Ethan-Poag/Flight-Data-Computer/README.md

# Flight-Data-Computer
An easy to build open source alternative to the ASA CX-3 aviation data computer.
