Ethan-Poag/Flight-Data-Computer/Calculator 3D Models/Calculator housing 3D model V2.step

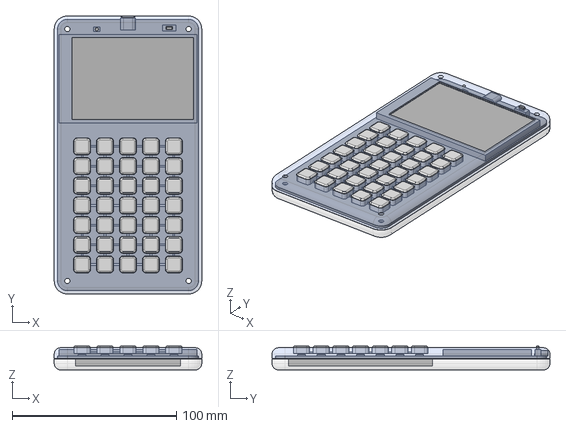
[picture p1: CAD file, 2022-11-27]
Calculator 3D Models/Calculator housing 3D model V2.step
90.0 x 169.5 x 14.6 mm
