Ethan-Poag/Flight-Data-Computer/Calculator_PCB_V3/Calculator.kicad_pcb

## KiCad design Calculator_PCB_V3/Calculator.kicad_pcb (2022-11-27)

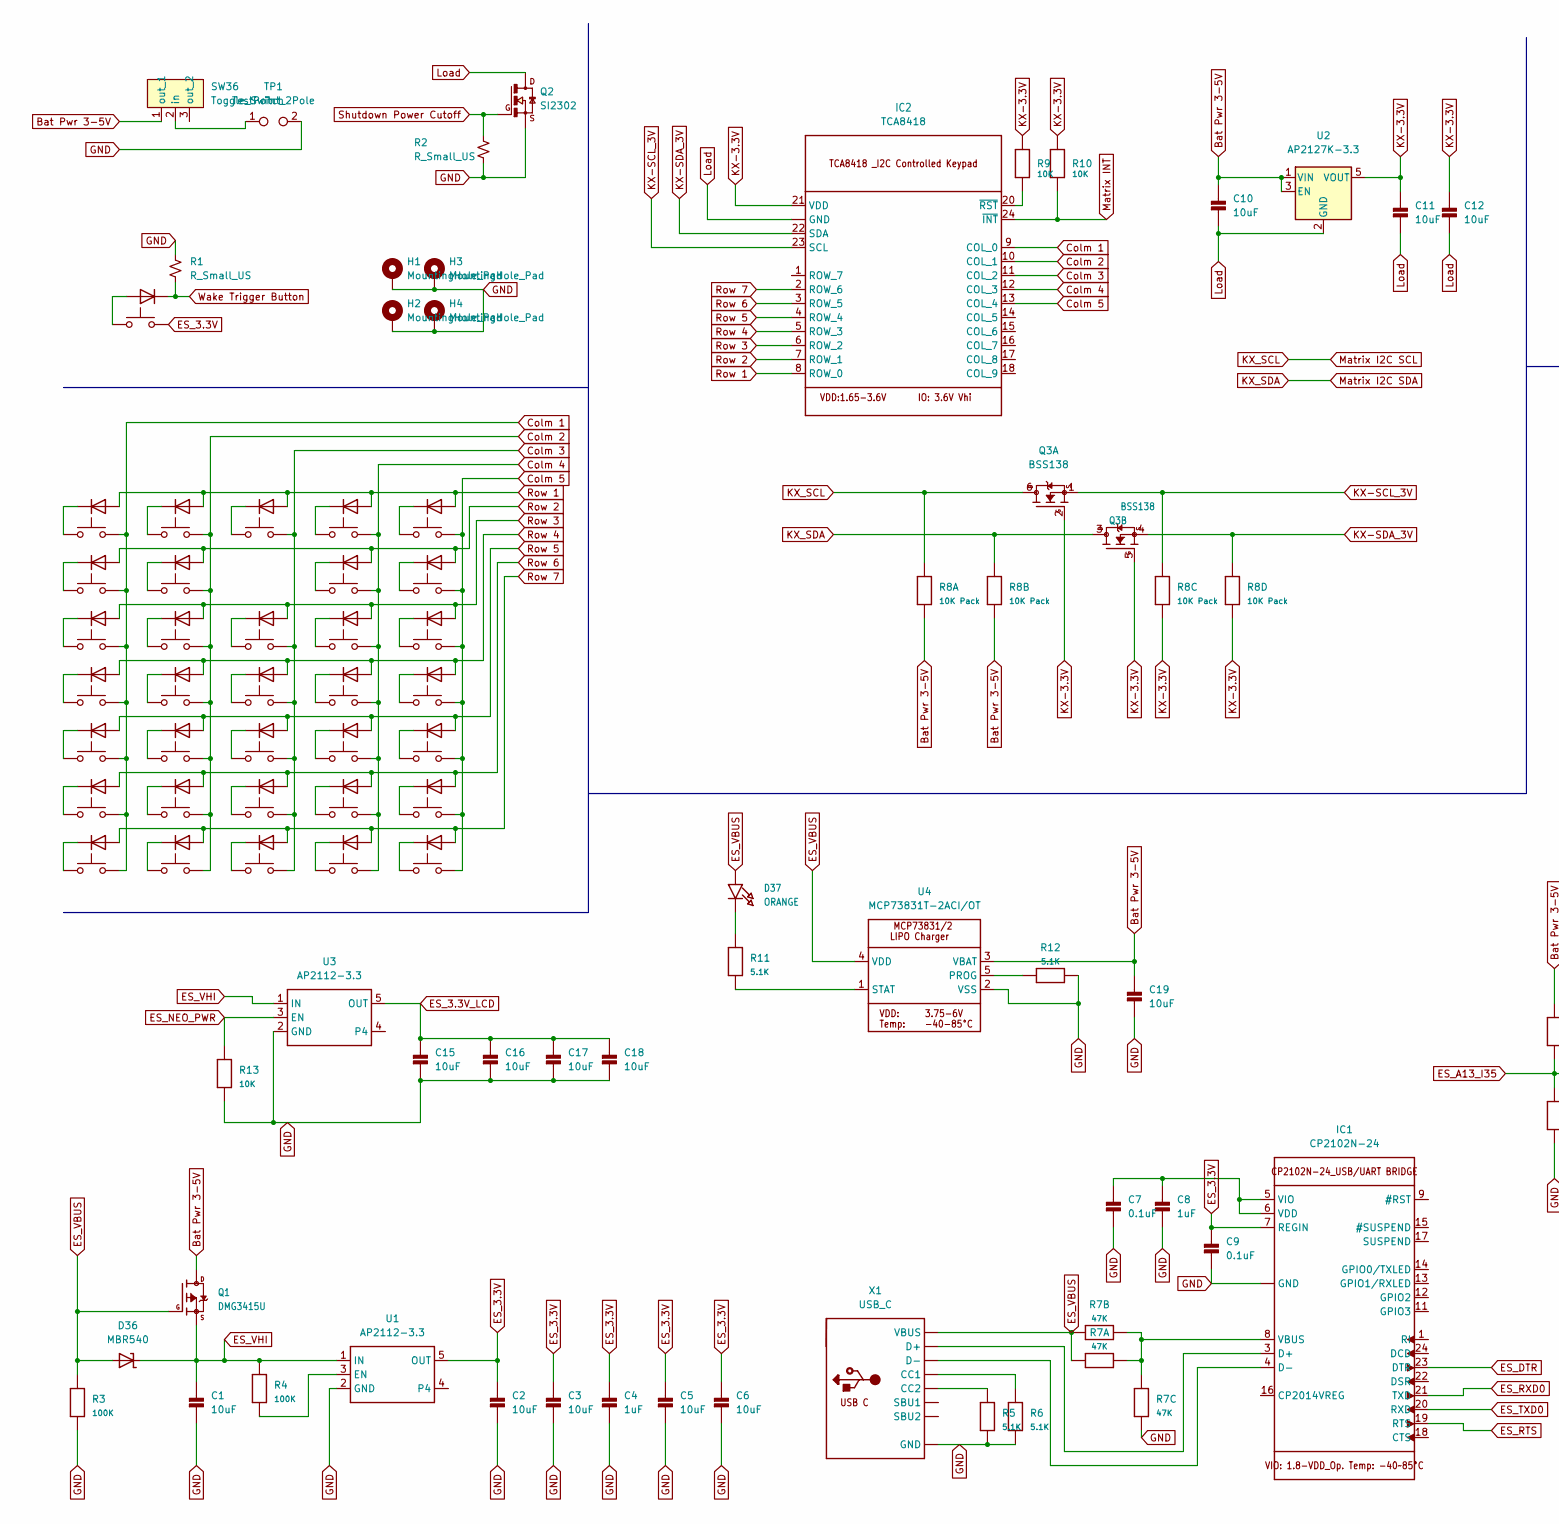
[picture p2: schematic Calculator.kicad_sch, part in row 1, column 1]

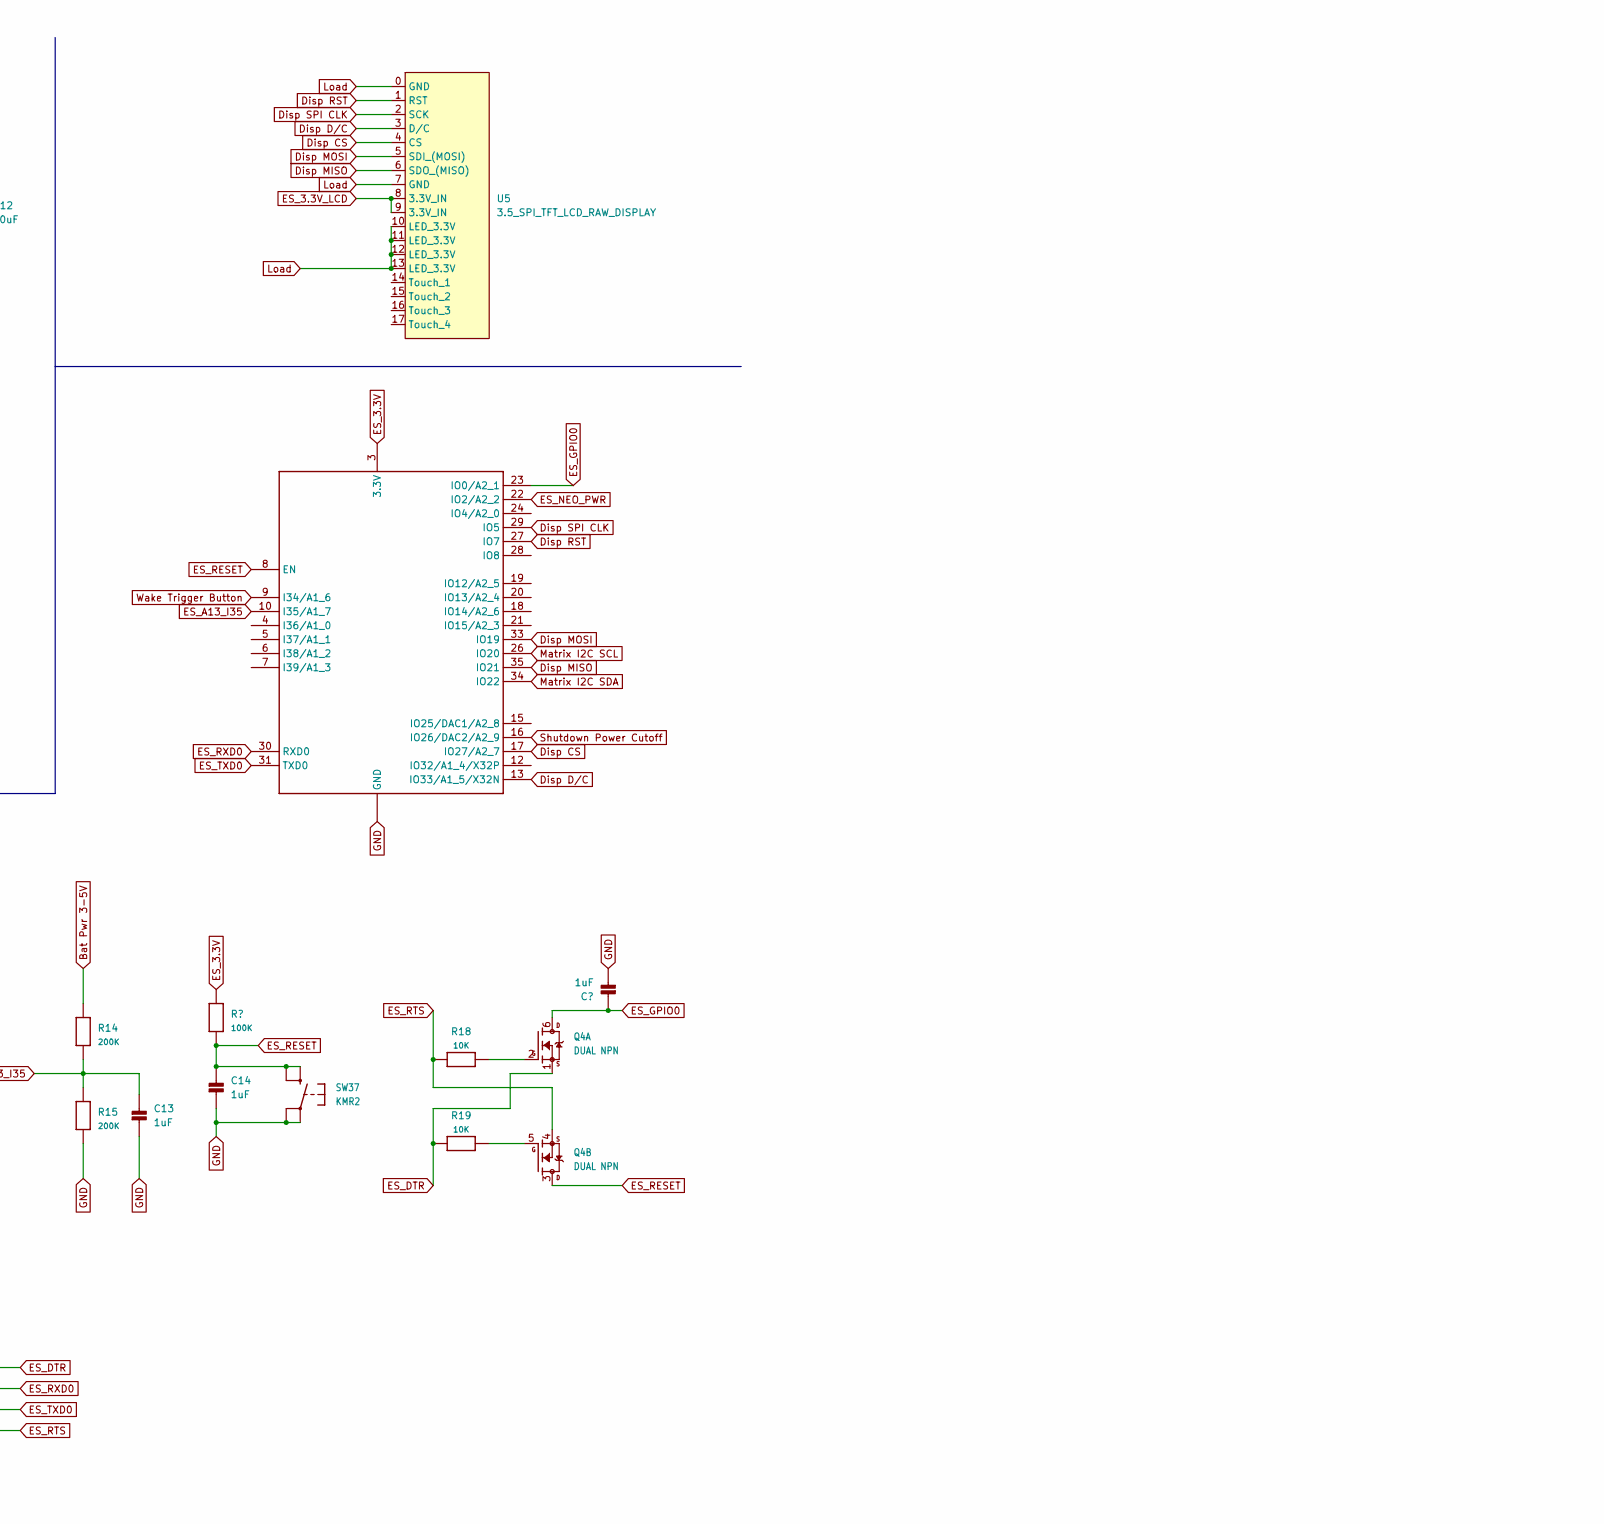
[picture p3: schematic Calculator.kicad_sch, part in row 1, column 2]

Parts:
C1, C2, C3, C5, C6, C10, C11, C12, C15, C16, C17, C18, C19: 10uF; 0805-NO
C4, C8, C13, C14: 1uF; 0805-NO
C7, C9: 0.1uF; 0805-NO
D1, D2, D3, D4, D5, D6, D7, D8, D9, D10, D11, D12, D13, D14, D15, D16, D17, D18, D19, D20, D21, D22, D23, D24, D25, D26, D27, D28, D29, D30, D31, D32, D33, D34, D35: 1N4148WT; D_SOD-523
D36: MBR540; SOD-123
D37: ORANGE; CHIPLED_0603_NOOUTLINE
H1, H2, H3, H4: MountingHole_Pad; MountingHole_3.2mm_M3_Pad_Via
IC1: CP2102N-24; QFN24_4MM_SMSC
IC2: TCA8418; QFN24_4MM_SMSC
Q1: DMG3415U; SOT23-R
Q2: SI2302; SOT23
Q3: BSS138; SOT363
Q4: DUAL NPN; SOT363
R1, R2: R_Small_US; R_0402_1005Metric
R3, R4: 100K; 0603-NO
R5, R6, R11, R12: 5.1K; 0603-NO
R7: 47K; RESPACK_4X0603
R8: 10K Pack; RESPACK_4X0603
R9, R10, R13, R18, R19: 10K; 0603-NO
R14, R15: 200K; 0603-NO
SW1, SW2, SW3, SW4, SW5, SW6, SW7, SW8, SW9, SW10, SW11, SW12, SW13, SW14, SW15, SW16, SW17, SW18, SW19, SW20, SW21, SW22, SW23, SW24, SW25, SW26, SW27, SW28, SW29, SW30, SW31, SW32, SW33, SW34, SW35: SW_Push; SW_TS-1187A-B-A-B
SW36: Toggle_Switch; FanPinHeader_1x03_P2.54mm_Vertical
SW37: KMR2; BTN_KMR2_4.6X2.8
TP1: TestPoint_2Pole; Battery Solder Pad
U1, U3: AP2112-3.3; SOT23-5
U2: AP2127K-3.3; SOT-23-5
U4: MCP73831T-2ACI/OT; SOT23-5
U5: 3.5_SPI_TFT_LCD_RAW_DISPLAY
X1: USB_C; USB_C_CUSB31-CFM2AX-01-X
X2: ESP32-PICO-MINI-02MINI; ESP32-PICO-MINI

Connections:
Bat Pwr 3-5V: C10.1, C19.1, Q1.3 (D), R8.7 (2), R8.8 (2), R14.2, SW36.1 (out_1), U2.1 (VIN), U2.3 (EN), U4.3 (VBAT)
Colm 1: IC2.9 (COL_0), SW1.2, SW2.2, SW3.2, SW4.2, SW5.2, SW6.2, SW7.2
Colm 2: IC2.10 (COL_1), SW8.2, SW9.2, SW10.2, SW11.2, SW12.2, SW13.2, SW14.2
Colm 3: IC2.11 (COL_2), SW15.2, SW17.2, SW18.2, SW19.2, SW20.2, SW21.2
Colm 4: IC2.12 (COL_3), SW22.2, SW23.2, SW24.2, SW25.2, SW26.2, SW27.2, SW28.2
Colm 5: IC2.13 (COL_4), SW29.2, SW30.2, SW31.2, SW32.2, SW33.2, SW34.2, SW35.2
Disp CS: U5.4 (CS), X2.17 (IO27/A2_7)
Disp D/C: U5.3 (D/C), X2.13 (IO33/A1_5/X32N)
Disp MISO: U5.6 (SDO_(MISO)), X2.35 (IO21)
Disp MOSI: U5.5 (SDI_(MOSI)), X2.33 (IO19)
Disp RST: U5.1 (RST), X2.27 (IO7)
Disp SPI CLK: U5.2 (SCK), X2.29 (IO5)
ES_3.3V_LCD: C15.1, C16.1, C17.1, C18.1, U3.5 (OUT), U5.8 (3.3V_IN), U5.9 (3.3V_IN)
ES_A13_I35: C13.1, R14.1, R15.2, X2.10 (I35/A1_7)
ES_DTR: IC1.23 (DTR), Q4.1 (S), R19.2
ES_GPIO0: Q4.6 (D), X2.23 (IO0/A2_1)
ES_NEO_PWR: R13.2, U3.3 (EN), X2.22 (IO2/A2_2)
ES_RESET: C14.1, Q4.3 (D), SW37.B (S), SW37.B' (S1), X2.8 (EN); also elsewhere on the board
ES_RTS: IC1.19 (RTS), Q4.4 (S), R18.2
ES_RXD0: IC1.21 (TXD), X2.30 (RXD0)
ES_TXD0: IC1.20 (RXD), X2.31 (TXD0)
ES_VHI: C1.1, D36.C, Q1.2 (S), R4.1, U1.1 (IN), U3.1 (IN)
KX-3.3V: C11.1, C12.1, IC2.21 (VDD), Q3.2 (G), Q3.5 (G), R8.5 (2), R8.6 (2), R9.2, R10.2, U2.5 (VOUT)
KX-SCL_3V: IC2.23 (SCL), Q3.1 (S), R8.3 (1)
KX-SDA_3V: IC2.22 (SDA), Q3.4 (S), R8.4 (1)
KX_SCL: Q3.6 (D), R8.1, X2.26 (IO20)
KX_SDA: Q3.3 (D), R8.2 (1), X2.34 (IO22)
Matrix INT: IC2.24 (~INT), R10.1
unnamed: C7.1, C8.1, IC1.5 (VIO), IC1.6 (VDD)
unnamed: D1.1 (K), SW1.1
unnamed: D2.1 (K), SW2.1
unnamed: D3.1 (K), SW3.1
unnamed: D4.1 (K), SW4.1
unnamed: D5.1 (K), SW5.1
unnamed: D6.1 (K), SW6.1
unnamed: D7.1 (K), SW7.1
unnamed: D8.1 (K), SW8.1
unnamed: D9.1 (K), SW9.1
unnamed: D10.1 (K), SW10.1
unnamed: D11.1 (K), SW11.1
unnamed: D12.1 (K), SW12.1
unnamed: D13.1 (K), SW13.1
unnamed: D14.1 (K), SW14.1
unnamed: D15.1 (K), SW15.1
unnamed: D16.2 (A), SW16.1
unnamed: D17.1 (K), SW17.1
unnamed: D18.1 (K), SW18.1
unnamed: D19.1 (K), SW19.1
unnamed: D20.1 (K), SW20.1
unnamed: D21.1 (K), SW21.1
unnamed: D22.1 (K), SW22.1
unnamed: D23.1 (K), SW23.1
unnamed: D24.1 (K), SW24.1
unnamed: D25.1 (K), SW25.1
unnamed: D26.1 (K), SW26.1
unnamed: D27.1 (K), SW27.1
unnamed: D28.1 (K), SW28.1
unnamed: D29.1 (K), SW29.1
unnamed: D30.1 (K), SW30.1
unnamed: D31.1 (K), SW31.1
unnamed: D32.1 (K), SW32.1
unnamed: D33.1 (K), SW33.1
unnamed: D34.1 (K), SW34.1
unnamed: D35.1 (K), SW35.1
unnamed: D37.C, R11.2
unnamed: IC1.3 (D+), X1.A6 (D+), X1.B6 (D+)
unnamed: IC1.4 (D-), X1.A7 (D-), X1.B7 (D-)
unnamed: IC1.8 (VBUS), R7.6 (2), R7.7 (2), R7.8 (2)
unnamed: IC2.20 (~RST), R9.1
unnamed: Q4.2 (G), R18.1
unnamed: Q4.5 (G), R19.1
unnamed: R4.2, U1.3 (EN)
unnamed: R5.2, X1.B5 (CC2)
unnamed: R6.2, X1.A5 (CC1)
unnamed: R11.1, U4.1 (STAT)
unnamed: R12.2, U4.5 (PROG)
unnamed: SW36.2 (in), TP1.1
Row 1: D1.2 (A), D8.2 (A), D15.2 (A), D22.2 (A), D29.2 (A), IC2.8 (ROW_0)
Row 2: D2.2 (A), D9.2 (A), D23.2 (A), D30.2 (A), IC2.7 (ROW_1)
Row 3: D3.2 (A), D10.2 (A), D17.2 (A), D24.2 (A), D31.2 (A), IC2.6 (ROW_2)
Row 4: D4.2 (A), D11.2 (A), D18.2 (A), D25.2 (A), D32.2 (A), IC2.5 (ROW_3)
Row 5: D5.2 (A), D12.2 (A), D19.2 (A), D26.2 (A), D33.2 (A), IC2.4 (ROW_4)
Row 6: D6.2 (A), D13.2 (A), D20.2 (A), D27.2 (A), D34.2 (A), IC2.3 (ROW_5)
Row 7: D7.2 (A), D14.2 (A), D21.2 (A), D28.2 (A), D35.2 (A), IC2.2 (ROW_6)
Shutdown Power Cutoff: Q2.1, R2.1, X2.16 (IO26/DAC2/A2_9)
Wake Trigger Button: D16.1 (K), R1.2, X2.9 (I34/A1_6)

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
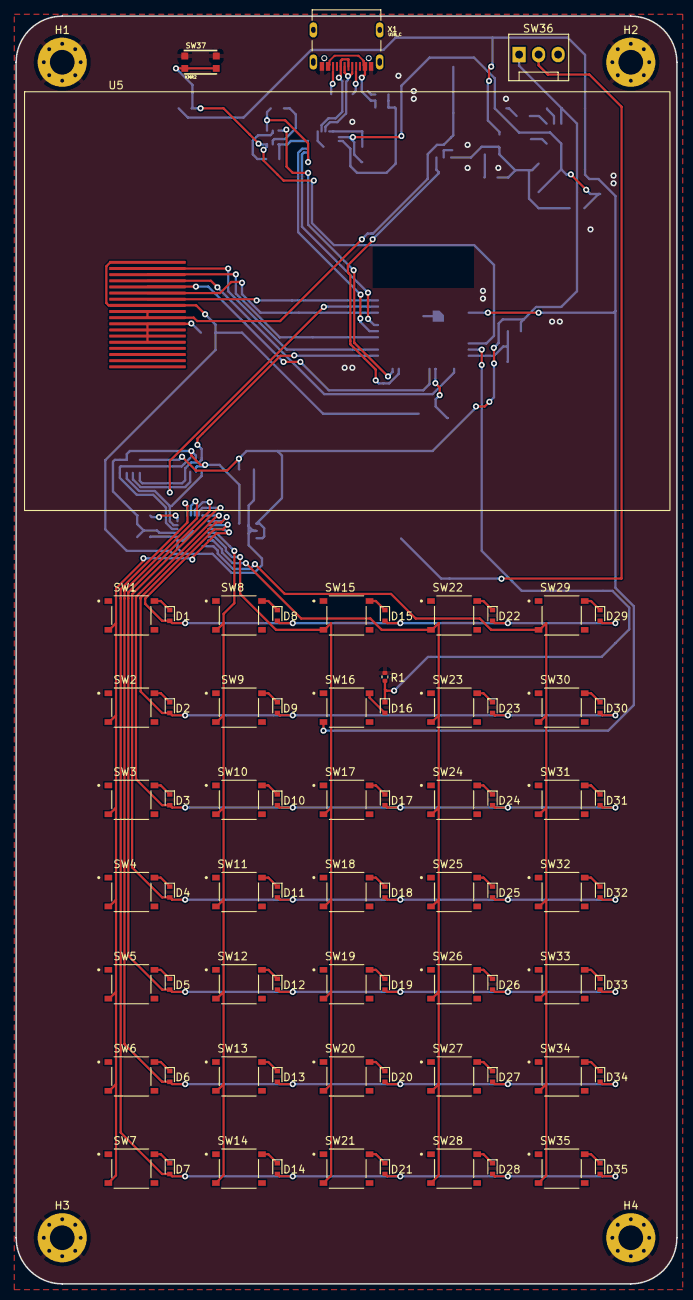
[picture p4: board Calculator_PCB_V3/Calculator.kicad_pcb from above]

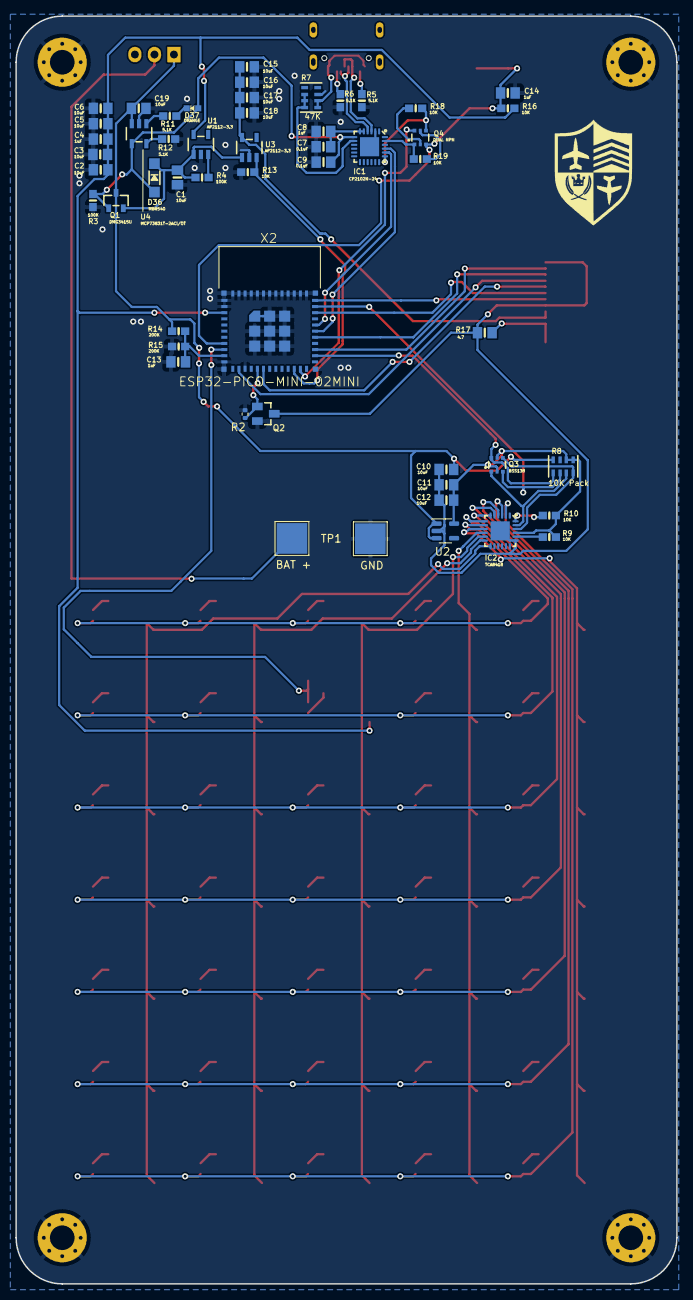
[picture p5: board Calculator_PCB_V3/Calculator.kicad_pcb from below]

Board: 2 copper layers, 86.0 x 165.0 mm, 130 parts (51 on the bottom side), 93 nets.

Other parts of the board:
R16: 10K; 0603-NO
R17: 4.7; 0805-NO

Their connections:
ES_RESET: R16.1; also elsewhere on the board
