Ethan-Poag/Flight-Data-Computer/PCB V1/Calculator.kicad_pcb

## KiCad design PCB V1/Calculator.kicad_pcb (2022-11-03, an earlier design)

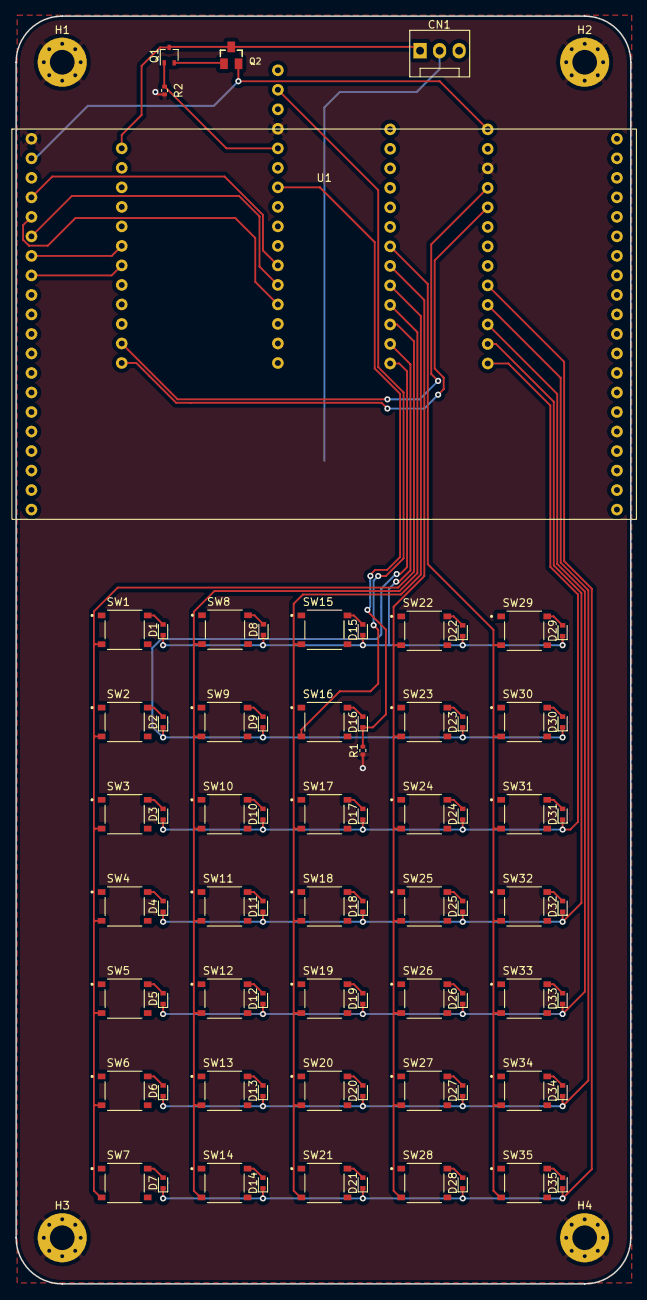
[picture p6: board PCB V1/Calculator.kicad_pcb from above]

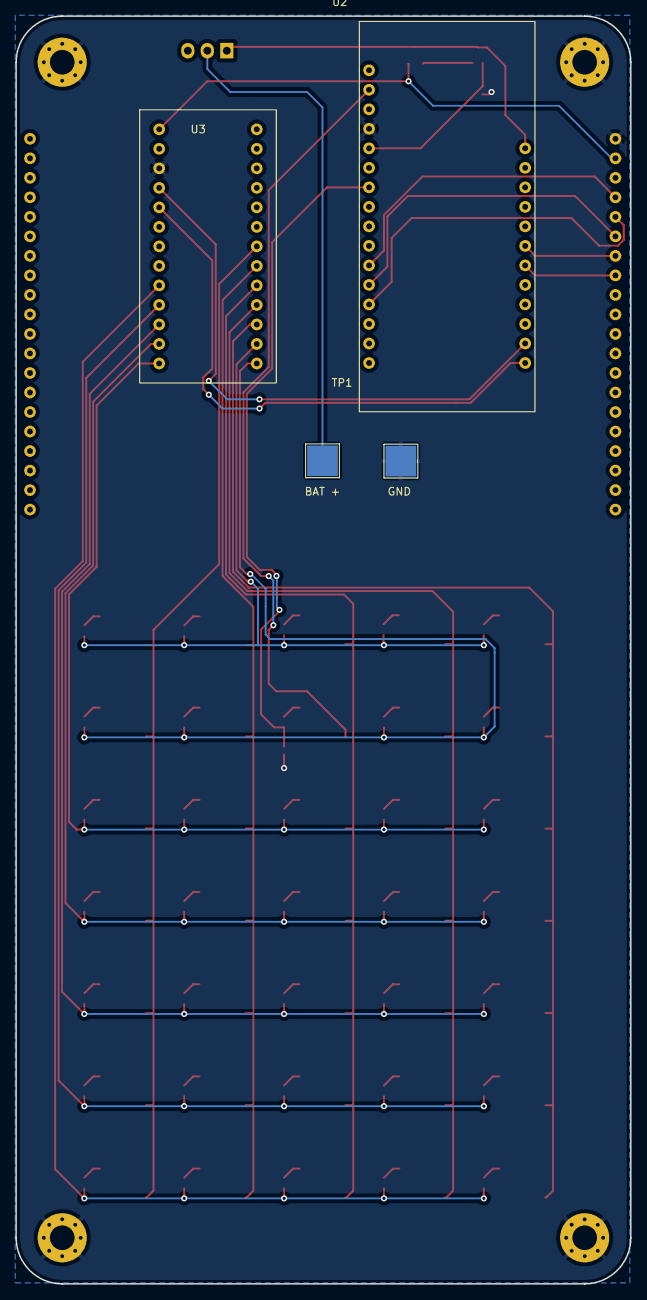
[picture p7: board PCB V1/Calculator.kicad_pcb from below]

Board: 2 copper layers, 80.0 x 165.0 mm, 83 parts (3 on the bottom side), 62 nets.

Parts:
CN1: Toggle_Switch; FanPinHeader_1x03_P2.54mm_Vertical
D1, D2, D3, D4, D5, D6, D7, D8, D9, D10, D11, D12, D13, D14, D15, D16, D17, D18, D19, D20, D21, D22, D23, D24, D25, D26, D27, D28, D29, D30, D31, D32, D33, D34, D35: 1N914WT; D_SOD-523
H1, H2, H3, H4: MountingHole_Pad; MountingHole_3.2mm_M3_Pad_Via
Q1: 2SC4213; SOT-323_SC-70
Q2: SI2302; SOT23
R1, R2: R_Small_US; R_0402_1005Metric
SW1, SW2, SW3, SW4, SW5, SW6, SW7, SW8, SW9, SW10, SW11, SW12, SW13, SW14, SW15, SW16, SW17, SW18, SW19, SW20, SW21, SW22, SW23, SW24, SW25, SW26, SW27, SW28, SW29, SW30, SW31, SW32, SW33, SW34, SW35: SW_Push; SW_TS-1187A-B-A-B
TP1: TestPoint_2Pole; Battery Solder Pad
U1: 2.8"_TFT_LCD_with_Touchscreen_Breakout_Board_w/Mi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; 2-8 TFT LCD with Touchscreen Breakout Board ILI9341
U2: Adafruit_ESP32_Feather_V2; Adafruit ESP32 Feather V2
U3: Adafruit_TCA8418_Keypad_Matrix_and_GPIO_Expander_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; Adafruit TCA8418 Keypad Matrix and GPIO Expander

Connections:
3-5V (ON): Q2.2, U1.18 (3-5V), U3.0 (VIN)
3V: SW16.2, U2.13 (3V)
Bat Pwr 3-5V: CN1.1 (out_1), Q1.3 (C), Q2.3, U2.0 (BAT)
Colm 1: SW1.2, SW2.2, SW3.2, SW4.2, SW5.2, SW6.2, SW7.2, U3.23 (C0)
Colm 2: SW8.2, SW9.2, SW10.2, SW11.2, SW12.2, SW13.2, SW14.2, U3.22 (C1)
Colm 3: SW15.2, SW17.2, SW18.2, SW19.2, SW20.2, SW21.2, U3.21 (C2)
Colm 4: SW22.2, SW23.2, SW24.2, SW25.2, SW26.2, SW27.2, SW28.2, U3.20 (C3)
Colm 5: SW29.2, SW30.2, SW31.2, SW32.2, SW33.2, SW34.2, SW35.2, U3.19 (C4)
Disp CS: U1.13 (CS), U2.5 (27/A10)
Disp D/C: U1.12 (D/C), U2.6 (33/A9)
Disp MISO: U1.15 (MISO), U2.24 (21/MISO)
Disp MOSI: U1.14 (MOSI), U2.23 (19/MOSI)
Disp SPI CLK: U1.16 (CLK), U2.22 (5/SCK)
GND: H1.1, H2.1, H3.1, H4.1, R1.1, R2.2, TP1.2, U1.19 (GND), U2.15 (GND), U3.2 (GND)
Matrix I2C SCL: U2.10 (SCL/20), U3.3 (SCL)
Matrix I2C SDA: U2.11 (SDA/22), U3.4 (SDA)
unnamed: D1.2 (A), SW1.1
unnamed: D2.2 (A), SW2.1
unnamed: D3.2 (A), SW3.1
unnamed: D4.2 (A), SW4.1
unnamed: D5.2 (A), SW5.1
unnamed: D6.2 (A), SW6.1
unnamed: D7.2 (A), SW7.1
unnamed: D8.2 (A), SW8.1
unnamed: D9.2 (A), SW9.1
unnamed: D10.2 (A), SW10.1
unnamed: D11.2 (A), SW11.1
unnamed: D12.2 (A), SW12.1
unnamed: D13.2 (A), SW13.1
unnamed: D14.2 (A), SW14.1
unnamed: D15.2 (A), SW15.1
unnamed: D16.2 (A), SW16.1
unnamed: D17.2 (A), SW17.1
unnamed: D18.2 (A), SW18.1
unnamed: D19.2 (A), SW19.1
unnamed: D20.2 (A), SW20.1
unnamed: D21.2 (A), SW21.1
unnamed: D22.2 (A), SW22.1
unnamed: D23.2 (A), SW23.1
unnamed: D24.2 (A), SW24.1
unnamed: D25.2 (A), SW25.1
unnamed: D26.2 (A), SW26.1
unnamed: D27.2 (A), SW27.1
unnamed: D28.2 (A), SW28.1
unnamed: D29.2 (A), SW29.1
unnamed: D30.2 (A), SW30.1
unnamed: D31.2 (A), SW31.1
unnamed: D32.2 (A), SW32.1
unnamed: D33.2 (A), SW33.1
unnamed: D34.2 (A), SW34.1
unnamed: D35.2 (A), SW35.1
unnamed: Q1.2 (E), Q2.1
unnamed: CN1.2 (in), TP1.1
Row 1: D1.1 (K), D8.1 (K), D15.1 (K), D22.1 (K), D29.1 (K), U3.24 (R0)
Row 2: D2.1 (K), D9.1 (K), D23.1 (K), D30.1 (K), U3.25 (R1)
Row 3: D3.1 (K), D10.1 (K), D17.1 (K), D24.1 (K), D31.1 (K), U3.12 (R2)
Row 4: D4.1 (K), D11.1 (K), D18.1 (K), D25.1 (K), D32.1 (K), U3.11 (R3)
Row 5: D5.1 (K), D12.1 (K), D19.1 (K), D26.1 (K), D33.1 (K), U3.10 (R4)
Row 6: D6.1 (K), D13.1 (K), D20.1 (K), D27.1 (K), D34.1 (K), U3.9 (R5)
Row 7: D7.1 (K), D14.1 (K), D21.1 (K), D28.1 (K), D35.1 (K), U3.8 (R6)
Shutdown Power Cutoff: Q1.1 (B), R2.1, U2.16 (26/A0)
Wake Trigger Button: D16.1 (K), R1.2, U2.18 (34/A2)
