Ethan-Poag/Flight-Data-Computer/Calculator Menu Code Working/LvglHelloWorld_TEST_COPPY_working/CALC_LCD_INIT.h

#include <lvgl.h>
#include <Arduino_GFX_Library.h>
#include "ui.h"

#define PWR_Cutoff 26
#define PWR_DISP_EN 2

#define GFX_BL DF_GFX_BL // default backlight pin, you may replace DF_GFX_BL to actual backlight pin

/* More dev device declaration: https://github.com/moononournation/Arduino_GFX/wiki/Dev-Device-Declaration */
#if defined(DISPLAY_DEV_KIT)
Arduino_GFX *gfx = create_default_Arduino_GFX();
#else /* !defined(DISPLAY_DEV_KIT) */

/* More data bus class: https://github.com/moononournation/Arduino_GFX/wiki/Data-Bus-Class */
Arduino_DataBus *bus = new Arduino_HWSPI(33 /* DC */, 27 /* CS */);

/* More display class: https://github.com/moononournation/Arduino_GFX/wiki/Display-Class */
Arduino_GFX *gfx = new Arduino_ILI9488(bus, 7, 3 /* rotation */, false /* IPS */);

#endif /* !defined(DISPLAY_DEV_KIT) */
/*******************************************************************************
 * End of Arduino_GFX setting
 ******************************************************************************/

/* Change to your screen resolution */
static uint32_t screenWidth;
static uint32_t screenHeight;
static lv_disp_draw_buf_t draw_buf;
static lv_color_t *disp_draw_buf;
static lv_color_t *disp_draw_buf2;
static lv_disp_drv_t disp_drv;

/* Display flushing */
void my_disp_flush(lv_disp_drv_t *disp, const lv_area_t *area, lv_color_t *color_p)
{
  uint32_t w = (area->x2 - area->x1 + 1);
  uint32_t h = (area->y2 - area->y1 + 1);

#if (LV_COLOR_16_SWAP != 0)
  gfx->draw16bitBeRGBBitmap(area->x1, area->y1, (uint16_t *)&color_p->full, w, h);
#else
  gfx->draw16bitRGBBitmap(area->x1, area->y1, (uint16_t *)&color_p->full, w, h);
#endif

  lv_disp_flush_ready(disp);
}




void LCD_INIT() 
{
  pinMode(PWR_Cutoff, OUTPUT);
  pinMode(PWR_DISP_EN, OUTPUT);

  digitalWrite(PWR_Cutoff, HIGH);
  digitalWrite(PWR_DISP_EN, HIGH);

  #ifdef GFX_PWD
  pinMode(GFX_PWD, OUTPUT);
  digitalWrite(GFX_PWD, HIGH);
  #endif

  // Init Display
  gfx->begin();
  gfx->fillScreen(BLACK);

  #ifdef GFX_BL
  pinMode(GFX_BL, OUTPUT);
  digitalWrite(GFX_BL, HIGH);
  #endif

  lv_init();

  screenWidth = gfx->width();
  screenHeight = gfx->height();
  #ifdef ESP32
  disp_draw_buf = (lv_color_t *)heap_caps_malloc(sizeof(lv_color_t) * screenWidth * 32, MALLOC_CAP_INTERNAL | MALLOC_CAP_8BIT);
  // disp_draw_buf2 = (lv_color_t *)heap_caps_malloc(sizeof(lv_color_t) * screenWidth * 32, MALLOC_CAP_INTERNAL | MALLOC_CAP_8BIT);
  #else
  disp_draw_buf = (lv_color_t *)malloc(sizeof(lv_color_t) * screenWidth * 32);
  #endif
  if (!disp_draw_buf)
  {
    Serial.println("LVGL disp_draw_buf allocate failed!");
  }
  else
  {
    if (!disp_draw_buf2)
    {
      Serial.println("LVGL disp_draw_buf2 not allocated!");
      lv_disp_draw_buf_init(&draw_buf, disp_draw_buf, NULL, screenWidth * 32);
    }
    else
    {
      lv_disp_draw_buf_init(&draw_buf, disp_draw_buf, disp_draw_buf2, screenWidth * 32);
    }

    /* Initialize the display */
    lv_disp_drv_init(&disp_drv);
    /* Change the following line to your display resolution */
    disp_drv.hor_res = screenWidth;
    disp_drv.ver_res = screenHeight;
    disp_drv.flush_cb = my_disp_flush;
    disp_drv.draw_buf = &draw_buf;
    lv_disp_drv_register(&disp_drv);

    /* Initialize the (dummy) input device driver */
    static lv_indev_drv_t indev_drv;
    lv_indev_drv_init(&indev_drv);
    indev_drv.type = LV_INDEV_TYPE_POINTER;
    lv_indev_drv_register(&indev_drv);

    /* Create simple label */
    lv_obj_t *label = lv_label_create(lv_scr_act());
    lv_label_set_text(label, "Hello Arduino! (V8.0.X)");
    lv_obj_align(label, LV_ALIGN_CENTER, 0, 0);

    

    Serial.println("Setup done");
  }

}
