Ethan-Poag/Flight-Data-Computer/Calculator Menu Code Working/LvglHelloWorld_TEST_COPPY_working/ui.h

// SquareLine LVGL GENERATED FILE
// EDITOR VERSION: SquareLine Studio 1.1.1
// LVGL VERSION: 8.3.3
// PROJECT: SquareLine_Project

#ifndef _SQUARELINE_PROJECT_UI_H
#define _SQUARELINE_PROJECT_UI_H

#ifdef __cplusplus
extern "C" {
#endif

#if defined __has_include
#if __has_include("lvgl.h")
#include "lvgl.h"
#elif __has_include("lvgl/lvgl.h")
#include "lvgl/lvgl.h"
#else
#include "lvgl.h"
#endif
#else
#include "lvgl.h"
#endif

extern lv_obj_t * ui_Screen1;
extern lv_obj_t * ui_Screen1_Panel1;
extern lv_obj_t * ui_WAKE_TITLE;
extern lv_obj_t * ui_Screen1_Label6;
extern lv_obj_t * ui_Screen1_Label7;
extern lv_obj_t * ui_Screen1_Roller1;
extern lv_obj_t * ui_Screen2;
extern lv_obj_t * ui_Screen2Panel1;
extern lv_obj_t * ui_WAKE_TITLE1;
extern lv_obj_t * ui_Screen1_Label1;
extern lv_obj_t * ui_Screen1_Label2;
extern lv_obj_t * ui_Screen2_Label1;






void ui_init(void);

#ifdef __cplusplus
} /*extern "C"*/
#endif

#endif
