Ethan-Poag/Flight-Data-Computer/(commit log)

2022-11-03 Add files via upload
    Uploading the first and second prototype PCB designs.
    [Calculator BOM.csv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]
2022-11-27 Version 3 of the calculator PCB
    Calculator PCB version 3. Everything on this PCB should be fully working as is with no modifications.
    [Calculator BOM.csv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]
2022-11-27 3D models for the calculator
    [Calculator housing 3D model V2.step]
